m-byte/fidget-pov/README.md

# fidgethw
https://hackaday.io/project/25372-iot-pov-fidget-spinner
