m-byte/fidget-pov/PCB/fidget.kicad_pcb

## KiCad design PCB/fidget.kicad_pcb (2017-06-14)

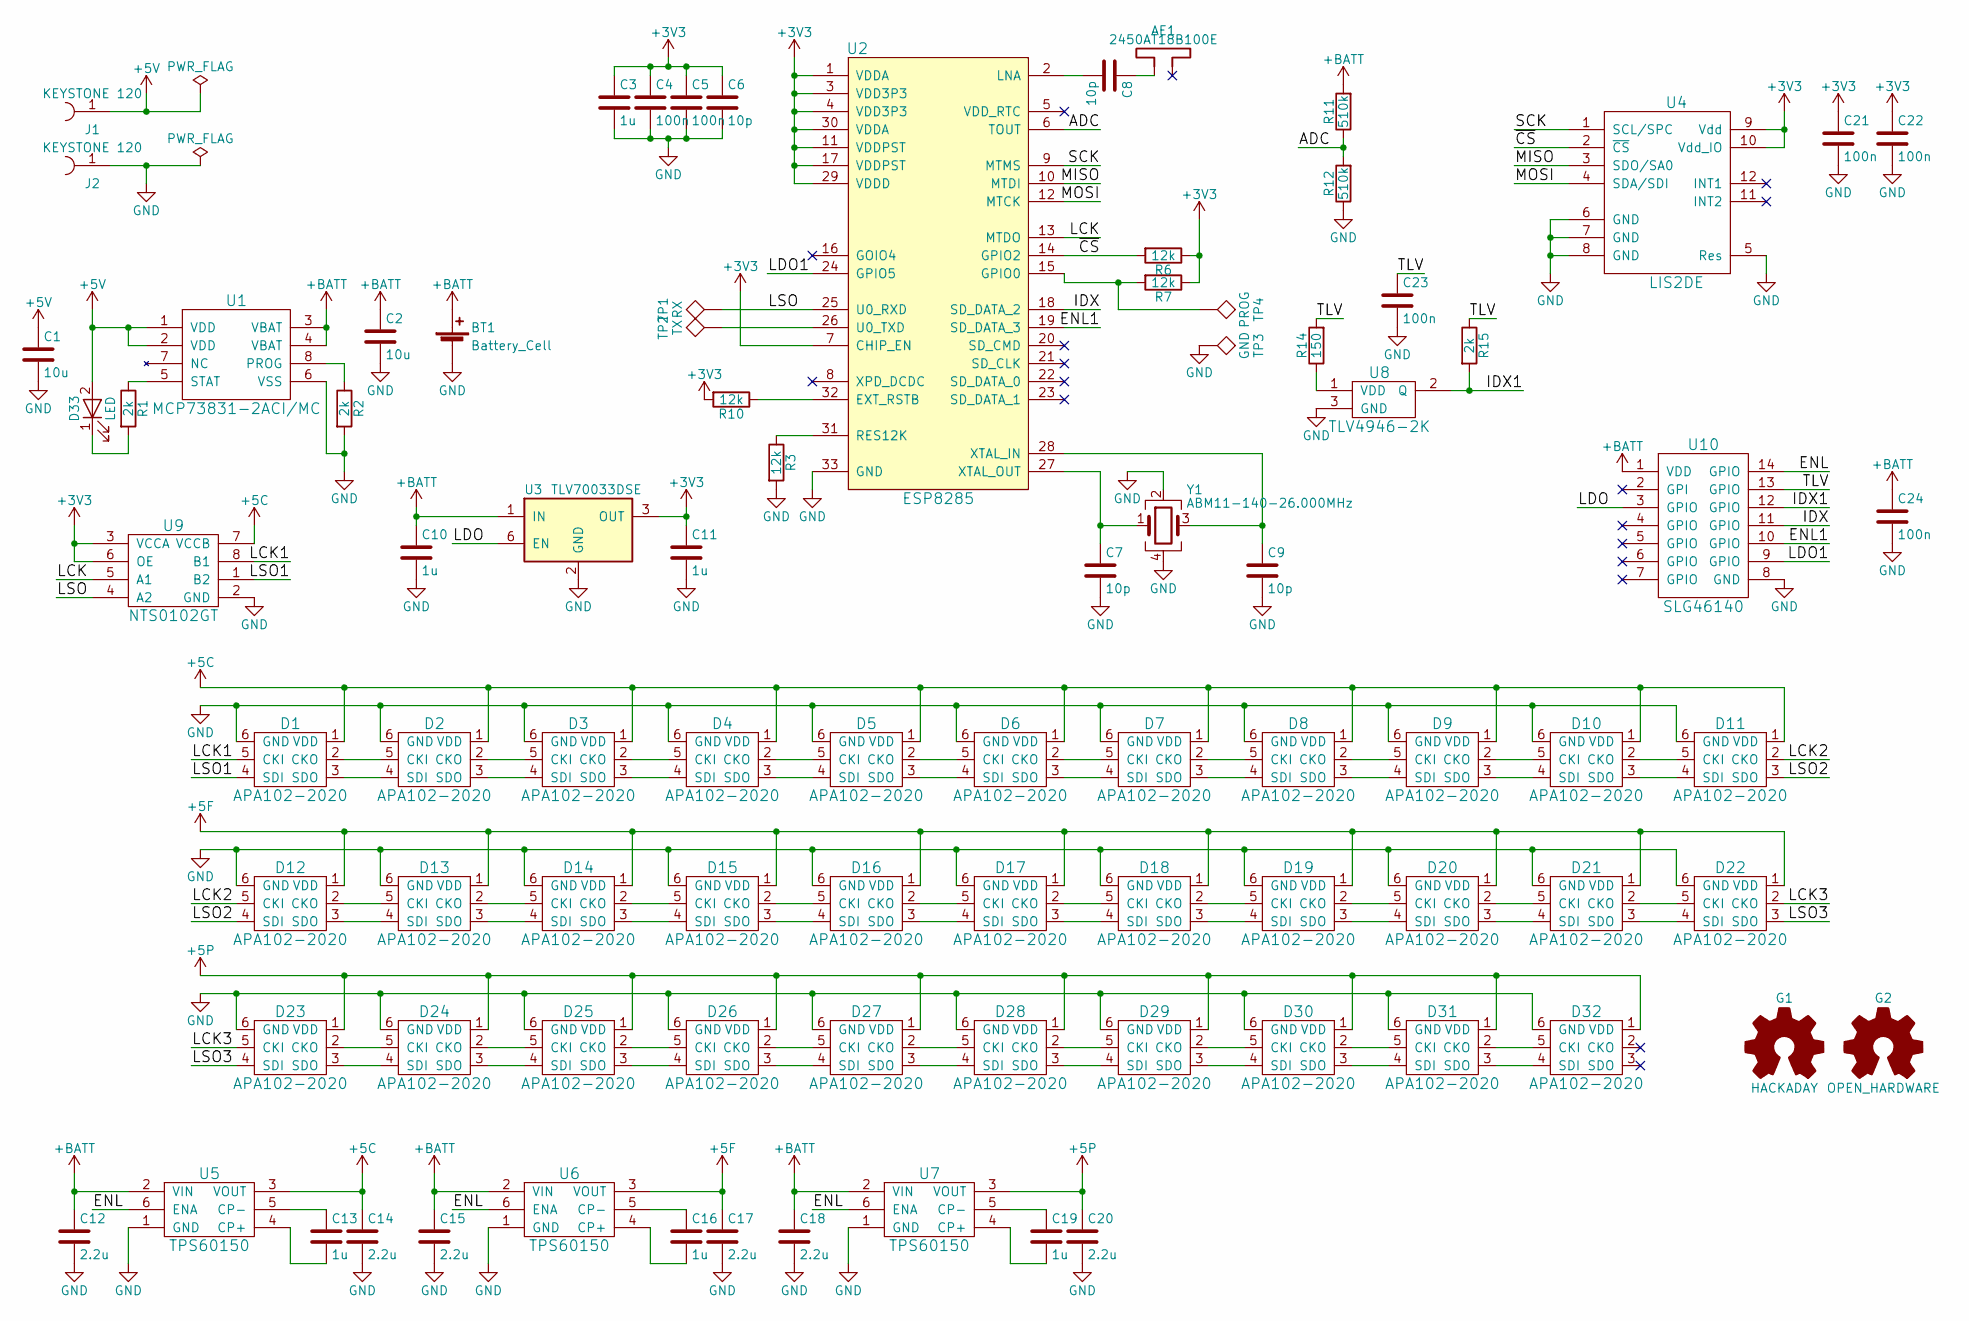
[picture p1: schematic fidget.sch, IoT POV Fidget Spinner]

Parts:
AE1: 2450AT18B100E; SMD-1206_Pol
BT1: Battery_Cell; Pin_Header_Straight_1x02_Pitch2.00mm
C1, C2: 10u; C_0603
C3, C10, C11: 1u; C_0402
C4, C5, C21, C22, C23, C24: 100n; C_0402
C6, C7, C8, C9: 10p; C_0402
C12, C14, C15, C17, C18, C20: 2.2u; C_0603
C13, C16, C19: 1u; C_0603
D1, D2, D3, D4, D5, D6, D7, D8, D9, D10, D11, D12, D13, D14, D15, D16, D17, D18, D19, D20, D21, D22, D23, D24, D25, D26, D27, D28, D29, D30, D31, D32: APA102-2020; LED_APA102-2020
D33: LED; LED_0805
G1: HACKADAY; wrencher_8mm
G2: OPEN_HARDWARE; OSHW-Logo_7.5x8mm_SilkScreen
J1, J2: KEYSTONE 120; Keystone_120_19mm
R1, R2, R15: 2k; R_0402
R3, R6, R7, R10: 12k; R_0402
R11, R12: 510k; R_0402
R14: 150; R_0402
TP1: RX; Measurement_Point_Round-SMD-Pad_Small
TP2: TX; Measurement_Point_Round-SMD-Pad_Small
TP3: GND; Measurement_Point_Round-SMD-Pad_Small
TP4: PROG; Measurement_Point_Round-SMD-Pad_Small
U1: MCP73831-2ACI/MC; DFN-8-1EP_3x2mm_Pitch0.5mm
U2: ESP8285; QFN-32-1EP_5x5mm_Pitch0.5mm
U3: TLV70033DSE; WSON6_1.5x1.5mm_Pitch0.5mm
U4: LIS2DE; LGA-12_2x2mm_Pitch0.5mm
U5, U6, U7: TPS60150; DFN-6-1EP_2x2mm_Pitch0.65mm
U8: TLV4946-2K; SC-59
U9: NTS0102GT; SOT833-1
U10: SLG46140; SILEGO_STQFN-14L-1.6x2mm_Pitch0.4mm
Y1: ABM11-140-26.000MHz; Crystal_SMD_2016-4pin_2.0x1.6mm

Connections:
+3V3: C3.1, C4.1, C5.1, C6.1, C11.1, C21.1, C22.1, R6.1, R7.1, R10.2, U2.1 (VDDA), U2.3 (VDD3P3), U2.4 (VDD3P3), U2.7 (CHIP_EN), U2.11 (VDDPST), U2.17 (VDDPST), U2.29 (VDDD), U2.30 (VDDA), U3.3 (OUT), U4.9 (Vdd), U4.10 (Vdd_IO), U9.3 (VCCA), U9.6 (OE)
+5C: C14.1, D1.1 (VDD), D2.1 (VDD), D3.1 (VDD), D4.1 (VDD), D5.1 (VDD), D6.1 (VDD), D7.1 (VDD), D8.1 (VDD), D9.1 (VDD), D10.1 (VDD), D11.1 (VDD), U5.3 (VOUT), U9.7 (VCCB)
+5F: C17.1, D12.1 (VDD), D13.1 (VDD), D14.1 (VDD), D15.1 (VDD), D16.1 (VDD), D17.1 (VDD), D18.1 (VDD), D19.1 (VDD), D20.1 (VDD), D21.1 (VDD), D22.1 (VDD), U6.3 (VOUT)
+5P: C20.1, D23.1 (VDD), D24.1 (VDD), D25.1 (VDD), D26.1 (VDD), D27.1 (VDD), D28.1 (VDD), D29.1 (VDD), D30.1 (VDD), D31.1 (VDD), D32.1 (VDD), U7.3 (VOUT)
+5V: C1.1, D33.2 (A), J1.1, U1.1 (VDD), U1.2 (VDD)
+BATT: BT1.1 (+), C2.1, C10.1, C12.1, C15.1, C18.1, C24.1, R11.2, U1.3 (VBAT), U1.4 (VBAT), U3.1 (IN), U5.2 (VIN), U6.2 (VIN), U7.2 (VIN), U10.1 (VDD)
/ADC: R11.1, R12.2, U2.6 (TOUT)
/ENL: U5.6 (ENA), U6.6 (ENA), U7.6 (ENA), U10.14 (GPIO)
/ENL1: U2.19 (SD_DATA_3), U10.10 (GPIO)
/IDX: U2.18 (SD_DATA_2), U10.11 (GPIO)
/IDX1: R15.2, U8.2 (Q), U10.12 (GPIO)
/LCK: U2.13 (MTDO), U9.5 (A1)
/LCK1: D1.5 (CKI), U9.8 (B1)
/LCK2: D11.2 (CKO), D12.5 (CKI)
/LCK3: D22.2 (CKO), D23.5 (CKI)
/LDO: U3.6 (EN), U10.3 (GPIO)
/LDO1: U2.24 (GPIO5), U10.9 (GPIO)
/LSO: TP1.1, U2.25 (U0_RXD), U9.4 (A2)
/LSO1: D1.4 (SDI), U9.1 (B2)
/LSO2: D11.3 (SDO), D12.4 (SDI)
/LSO3: D22.3 (SDO), D23.4 (SDI)
/MISO: U2.10 (MTDI), U4.3 (SDO/SA0)
/MOSI: U2.12 (MTCK), U4.4 (SDA/SDI)
/SCK: U2.9 (MTMS), U4.1 (SCL/SPC)
/TLV: C23.1, R14.2, R15.1, U10.13 (GPIO)
/~CS~: R6.2, U2.14 (GPIO2), U4.2 (~CS~)
GND: BT1.2 (-), C1.2, C2.2, C3.2, C4.2, C5.2, C6.2, C7.2, C9.2, C10.2, C11.2, C12.2, C14.2, C15.2, C17.2, C18.2, C20.2, C21.2, C22.2, C23.2, C24.2, D1.6 (GND), D2.6 (GND), D3.6 (GND), D4.6 (GND), D5.6 (GND), D6.6 (GND), D7.6 (GND), D8.6 (GND), D9.6 (GND), D10.6 (GND), D11.6 (GND), D12.6 (GND), D13.6 (GND), D14.6 (GND), D15.6 (GND), D16.6 (GND), D17.6 (GND), D18.6 (GND), D19.6 (GND), D20.6 (GND), D21.6 (GND), D22.6 (GND), D23.6 (GND), D24.6 (GND), D25.6 (GND), D26.6 (GND), D27.6 (GND), D28.6 (GND), D29.6 (GND), D30.6 (GND), D31.6 (GND), D32.6 (GND), J2.1, R2.2, R3.2, R12.1, TP3.1, U1.6 (VSS), U2.33 (GND), U3.2 (GND), U4.5 (Res), U4.6 (GND), U4.7 (GND), U4.8 (GND), U5.1 (GND), U6.1 (GND), U7.1 (GND), U8.3 (GND), U9.2 (GND), U10.8 (GND), Y1.2, Y1.4
unnamed: AE1.1, C8.1
unnamed: C7.1, U2.27 (XTAL_OUT), Y1.1
unnamed: C8.2, U2.2 (LNA)
unnamed: C9.1, U2.28 (XTAL_IN), Y1.3
unnamed: C13.1, U5.5 (CP-)
unnamed: C13.2, U5.4 (CP+)
unnamed: C16.1, U6.5 (CP-)
unnamed: C16.2, U6.4 (CP+)
unnamed: C19.1, U7.5 (CP-)
unnamed: C19.2, U7.4 (CP+)
unnamed: D1.2 (CKO), D2.5 (CKI)
unnamed: D1.3 (SDO), D2.4 (SDI)
unnamed: D2.2 (CKO), D3.5 (CKI)
unnamed: D2.3 (SDO), D3.4 (SDI)
unnamed: D3.2 (CKO), D4.5 (CKI)
unnamed: D3.3 (SDO), D4.4 (SDI)
unnamed: D4.2 (CKO), D5.5 (CKI)
unnamed: D4.3 (SDO), D5.4 (SDI)
unnamed: D5.2 (CKO), D6.5 (CKI)
unnamed: D5.3 (SDO), D6.4 (SDI)
unnamed: D6.2 (CKO), D7.5 (CKI)
unnamed: D6.3 (SDO), D7.4 (SDI)
unnamed: D7.2 (CKO), D8.5 (CKI)
unnamed: D7.3 (SDO), D8.4 (SDI)
unnamed: D8.2 (CKO), D9.5 (CKI)
unnamed: D8.3 (SDO), D9.4 (SDI)
unnamed: D10.2 (CKO), D11.5 (CKI)
unnamed: D10.3 (SDO), D11.4 (SDI)
unnamed: D9.3 (SDO), D10.4 (SDI)
unnamed: D9.2 (CKO), D10.5 (CKI)
unnamed: D12.2 (CKO), D13.5 (CKI)
unnamed: D12.3 (SDO), D13.4 (SDI)
unnamed: D13.2 (CKO), D14.5 (CKI)
unnamed: D13.3 (SDO), D14.4 (SDI)
unnamed: D14.2 (CKO), D15.5 (CKI)
unnamed: D14.3 (SDO), D15.4 (SDI)
unnamed: D15.2 (CKO), D16.5 (CKI)
unnamed: D15.3 (SDO), D16.4 (SDI)
unnamed: D16.2 (CKO), D17.5 (CKI)
unnamed: D16.3 (SDO), D17.4 (SDI)
unnamed: D17.2 (CKO), D18.5 (CKI)
unnamed: D17.3 (SDO), D18.4 (SDI)
unnamed: D18.2 (CKO), D19.5 (CKI)
unnamed: D18.3 (SDO), D19.4 (SDI)
unnamed: D19.2 (CKO), D20.5 (CKI)
unnamed: D19.3 (SDO), D20.4 (SDI)
unnamed: D20.2 (CKO), D21.5 (CKI)
unnamed: D20.3 (SDO), D21.4 (SDI)
unnamed: D21.2 (CKO), D22.5 (CKI)
unnamed: D21.3 (SDO), D22.4 (SDI)
unnamed: D23.2 (CKO), D24.5 (CKI)
unnamed: D23.3 (SDO), D24.4 (SDI)
unnamed: D24.2 (CKO), D25.5 (CKI)
unnamed: D24.3 (SDO), D25.4 (SDI)
unnamed: D25.2 (CKO), D26.5 (CKI)
unnamed: D25.3 (SDO), D26.4 (SDI)
unnamed: D26.2 (CKO), D27.5 (CKI)
unnamed: D26.3 (SDO), D27.4 (SDI)
unnamed: D27.2 (CKO), D28.5 (CKI)
unnamed: D27.3 (SDO), D28.4 (SDI)
unnamed: D28.2 (CKO), D29.5 (CKI)
unnamed: D28.3 (SDO), D29.4 (SDI)
unnamed: D29.2 (CKO), D30.5 (CKI)
unnamed: D29.3 (SDO), D30.4 (SDI)
unnamed: D30.2 (CKO), D31.5 (CKI)
unnamed: D30.3 (SDO), D31.4 (SDI)
unnamed: D31.2 (CKO), D32.5 (CKI)
unnamed: D31.3 (SDO), D32.4 (SDI)
unnamed: D33.1 (K), R1.2
unnamed: R1.1, U1.5 (STAT)
unnamed: R2.1, U1.8 (PROG)
unnamed: R3.1, U2.31 (RES12K)
unnamed: R7.2, TP4.1, U2.15 (GPIO0)
unnamed: R10.1, U2.32 (EXT_RSTB)
unnamed: R14.1, U8.1 (VDD)
unnamed: TP2.1, U2.26 (U0_TXD)

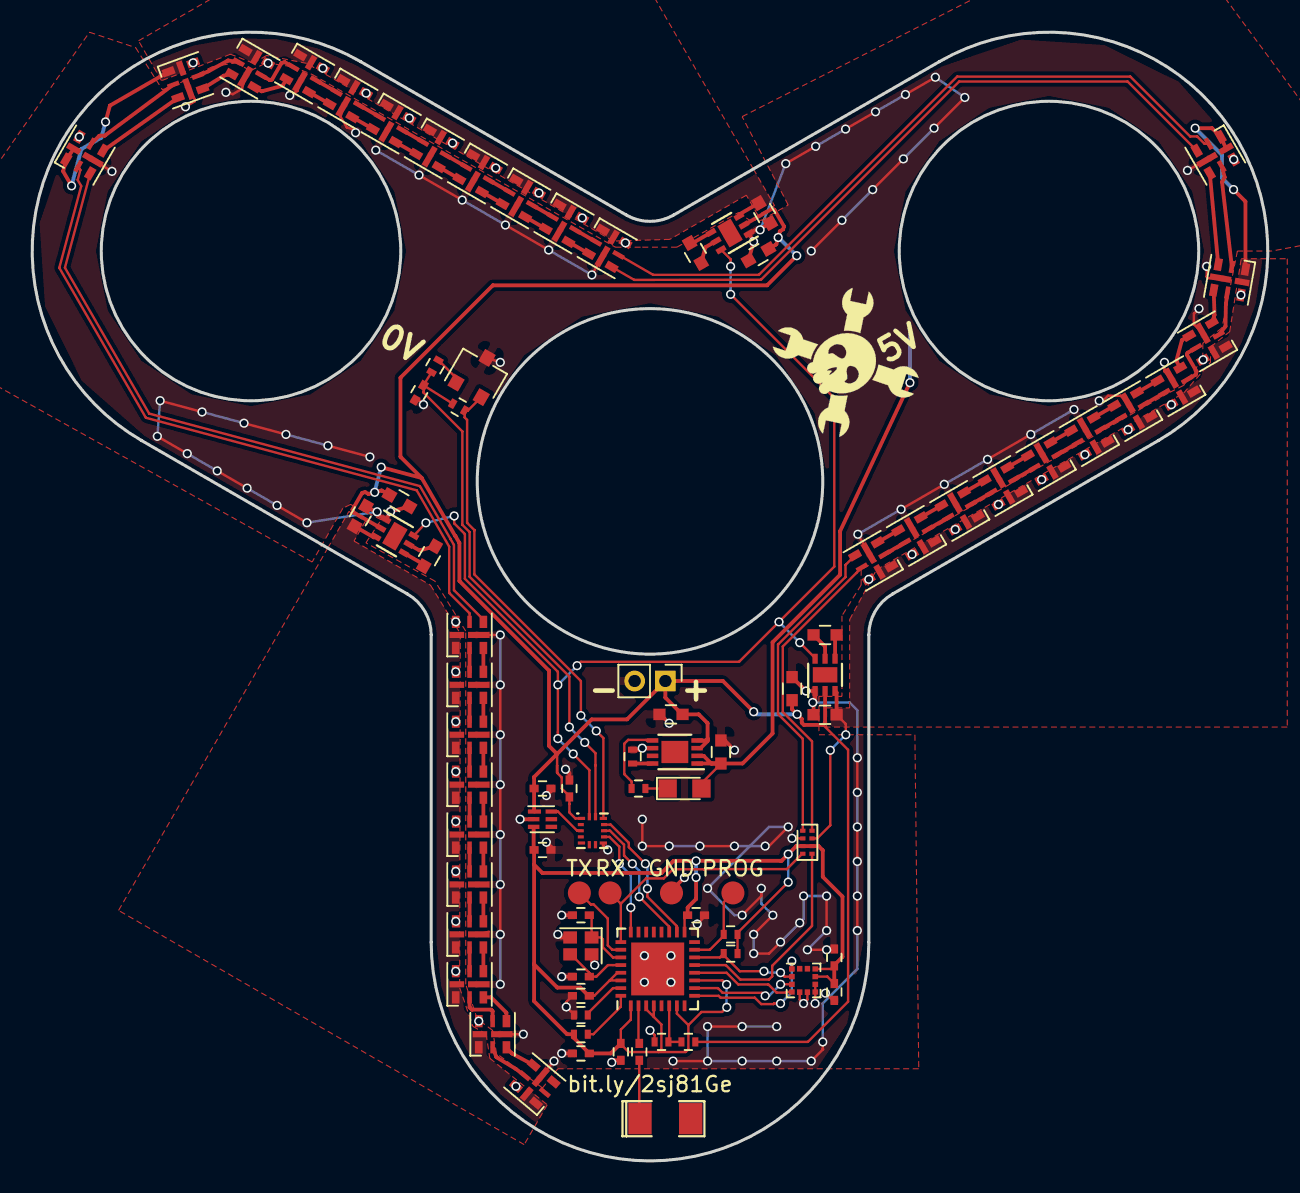
[picture p2: board fidget.kicad_pcb from above]

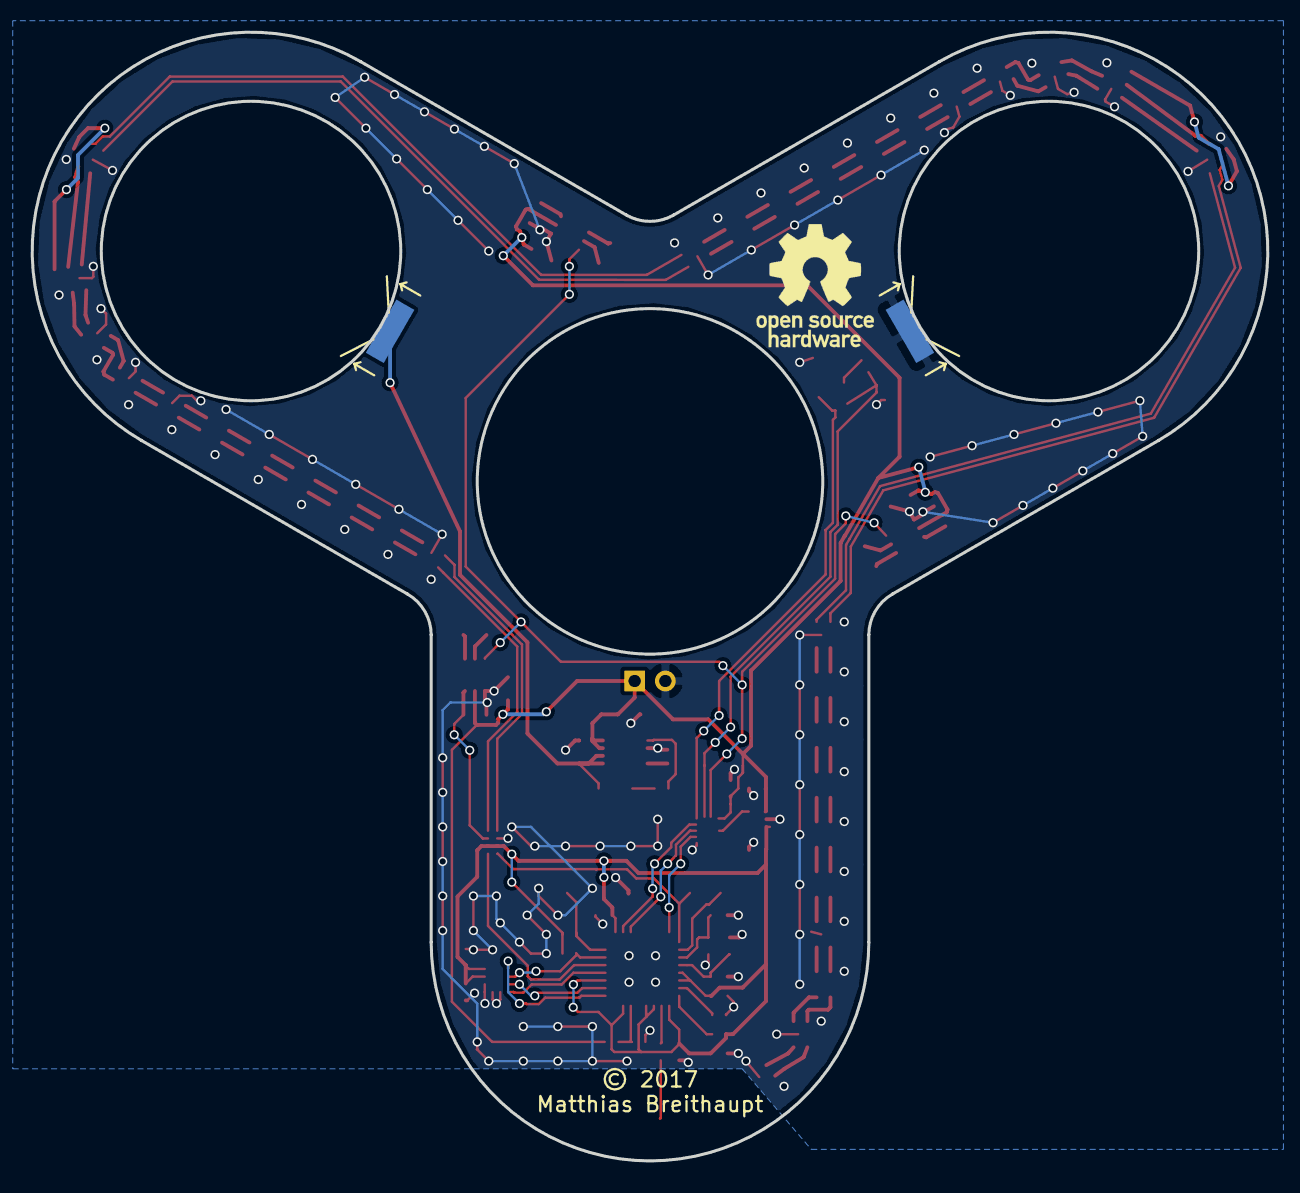
[picture p3: board fidget.kicad_pcb from below]

Board: 2 copper layers, 80.5 x 73.5 mm, 88 parts (3 on the bottom side), 103 nets.
