m-byte/fidget-pov/(commit log)

2017-06-09 schematic done
    [fidget.kicad_pcb, fidget.sch]
2017-06-10 PCB design at 4am.. probably a bad idea
    [fidget.kicad_pcb, fidget.sch]
2017-06-10 RTFM: reverse polarity protection is already inside MCP73831
    [fidget.kicad_pcb, fidget.sch]
2017-06-10 routing done
    [fidget.kicad_pcb, fidget.sch]
2017-06-10 cleaned up silkscreen
    [fidget.kicad_pcb, fidget.sch]
2017-06-11 added scad file
    [fidget.scad]
2017-06-11 added level shifter
    [fidget.kicad_pcb, fidget.scad, fidget.sch]
2017-06-13 switched to hall sensor
    [fidget.kicad_pcb, fidget.sch]
2017-06-13 added SLG46140 for UVLO and power management
    [fidget.kicad_pcb, fidget.sch]
2017-06-13 Changed file structure
    [fidget.kicad_pcb, fidget.scad, fidget.sch]
2017-06-13 moved hall sensor to battery rail so it can work with the LDO powered off
    [fidget.kicad_pcb, fidget.sch]
2017-06-13 added text to silkscreen
    [fidget.kicad_pcb]
2017-06-13 control power to hall sensor from pld
    [fidget.kicad_pcb, fidget.sch]
2017-06-14 increase center hole to 608 size - outer bearings are still 626
    [fidget.kicad_pcb]
2017-06-14 fixed silkscreen
    [fidget.kicad_pcb]
