m-byte/fidget-pov/(notices)

Notices in the files:
PCB/fidget.kicad_pcb:
© 2017
